mikedeblin/ESP32MediaBox/case/keys_caps.stl

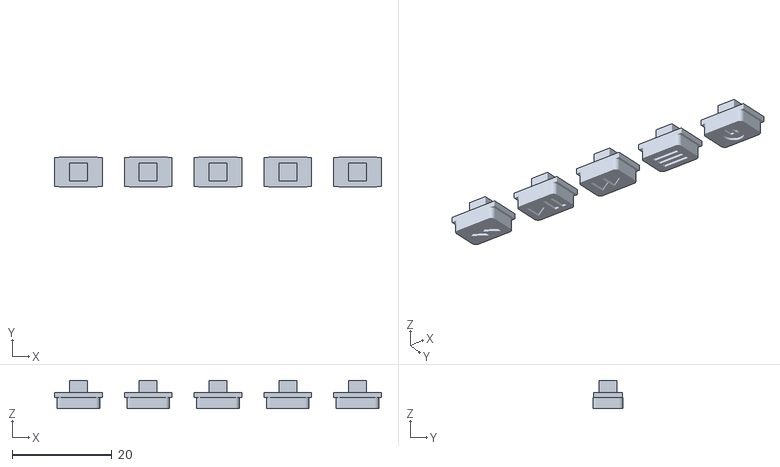
[picture p2: CAD file, 2026-10-10]
case/keys_caps.stl
65.6 x 6.10 x 5.65
