mikedeblin/ESP32MediaBox/case/knob.stl

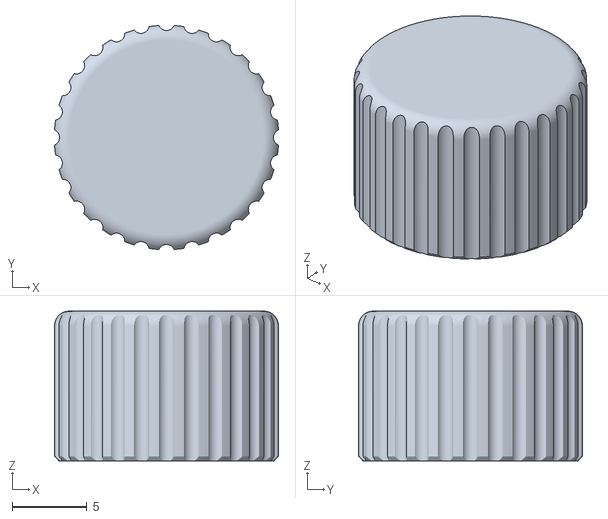
[picture p3: CAD file, 2026-10-10]
case/knob.stl
15.0 x 15.0 x 10.0
