mikedeblin/ESP32MediaBox/case/keys_symbols.stl

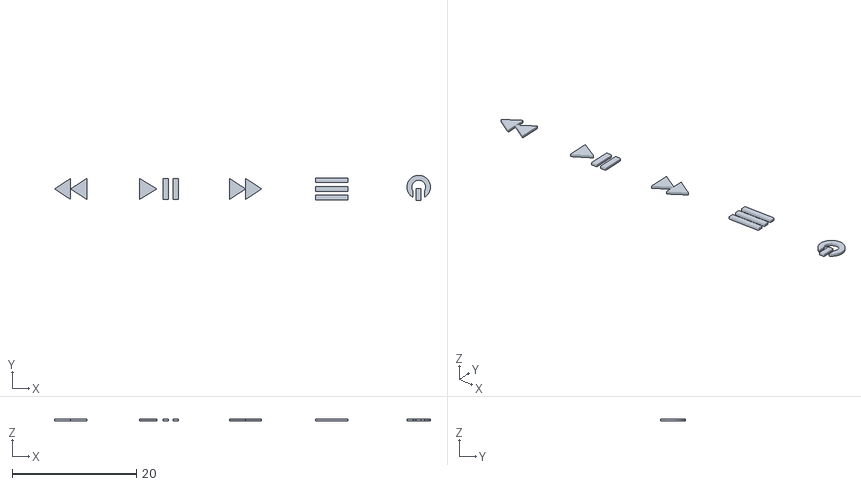
[picture p4: CAD file, 2026-10-10]
case/keys_symbols.stl
60.6 x 4.10 x 0.4
