mikedeblin/ESP32MediaBox/case/case_front.stl

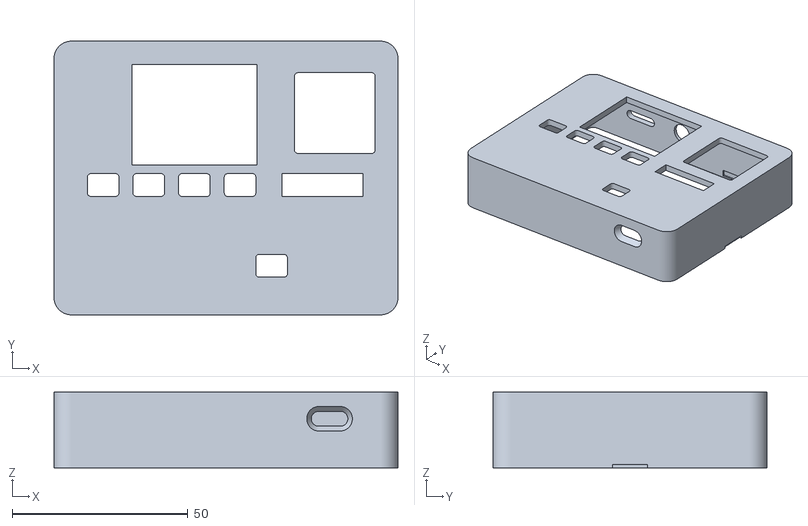
[picture p5: CAD file, 2026-10-10]
case/case_front.stl
98.0 x 78.0 x 21.6
