mikedeblin/ESP32MediaBox/case/case_rear.stl

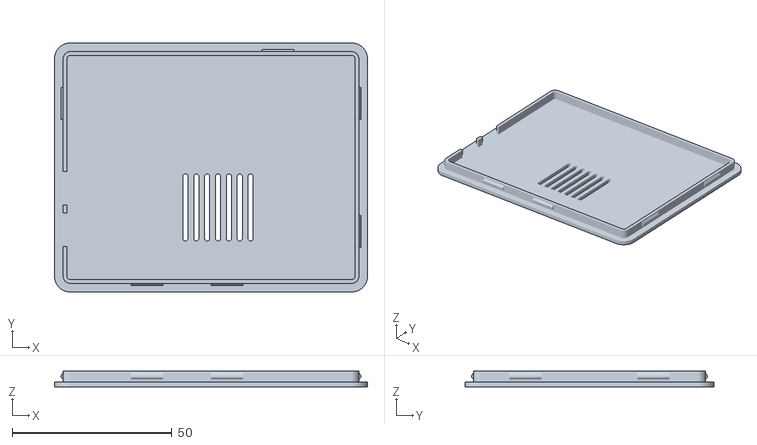
[picture p6: CAD file, 2026-10-10]
case/case_rear.stl
98.0 x 78.0 x 5.00
