mikedeblin/ESP32MediaBox/firmware/secrets.example.h

// Copy to secrets.h and fill in. secrets.h is in .gitignore.
// Скопируй в secrets.h и заполни. secrets.h в .gitignore.
#pragma once
#define WIFI_SSID         "your-ssid"
#define WIFI_PASS         "your-password"
// Synology Audio Station: http://<nas-ip>:50001/ContentDirectory/control
#define DLNA_CONTROL_URL  "http://192.168.1.10:50001/ContentDirectory/control"
#define DLNA_NAME         "My NAS"
